igi79/myNixies/img/20190120_131034.jpg

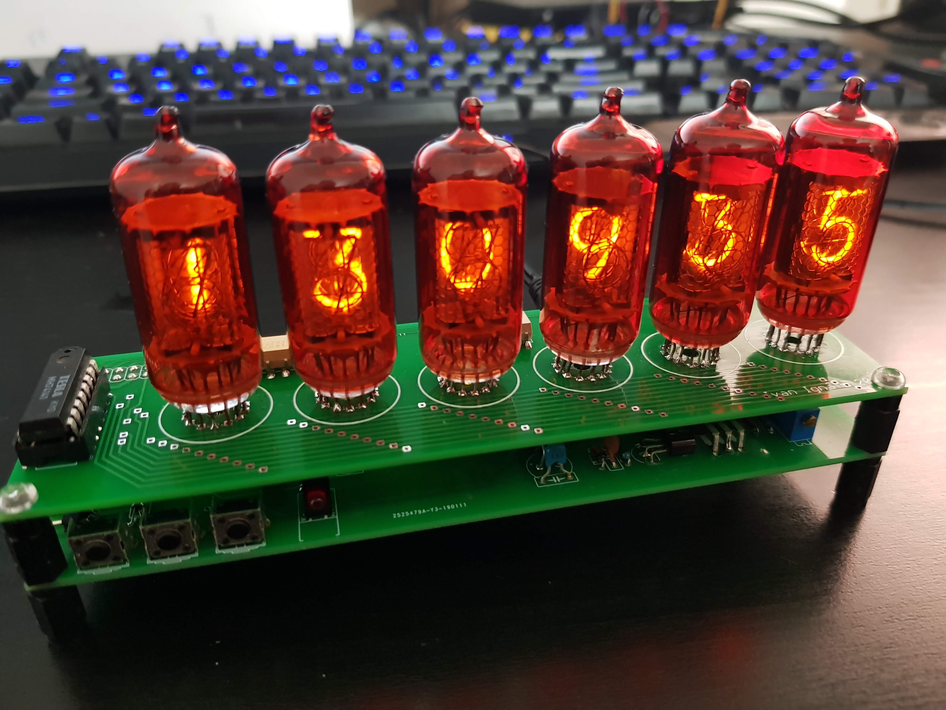
img/20190120_131034.jpg
