igi79/myNixies/img/20190220_234951.jpg

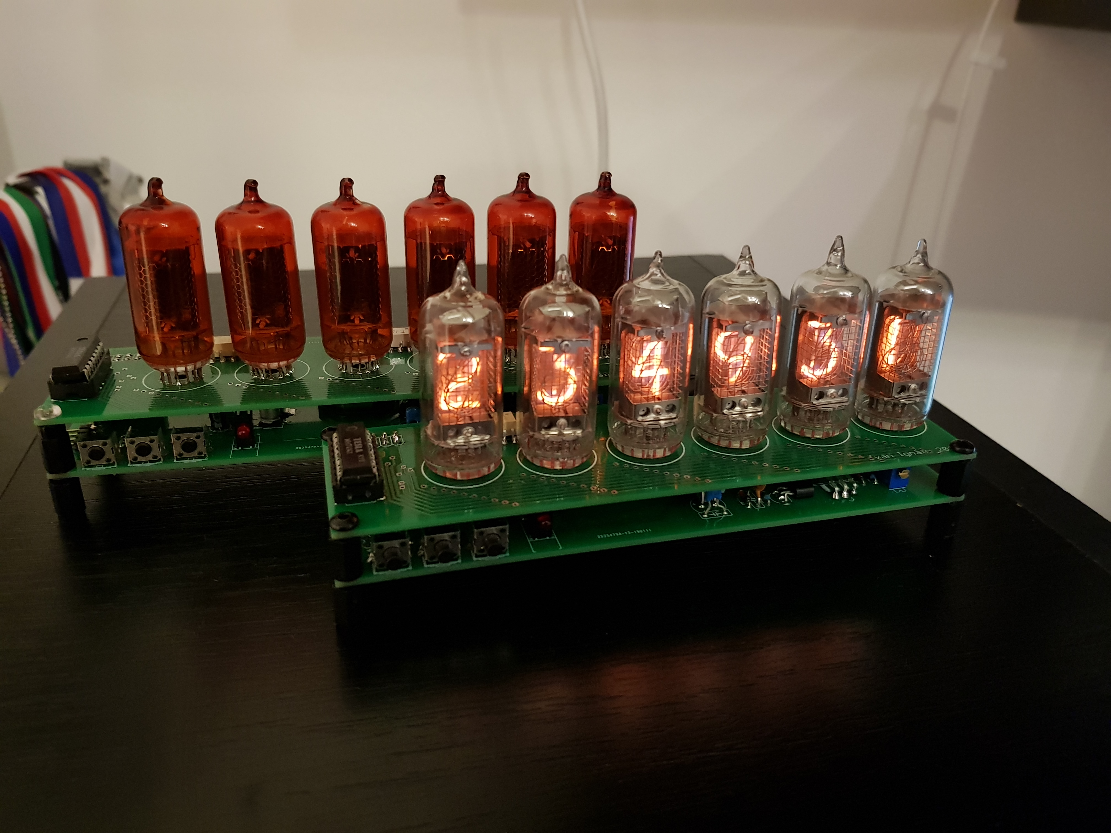
img/20190220_234951.jpg
