igi79/myNixies/PCB/nix3PowerFinal.brd

## EAGLE design PCB/nix3PowerFinal.brd (2019-02-20)

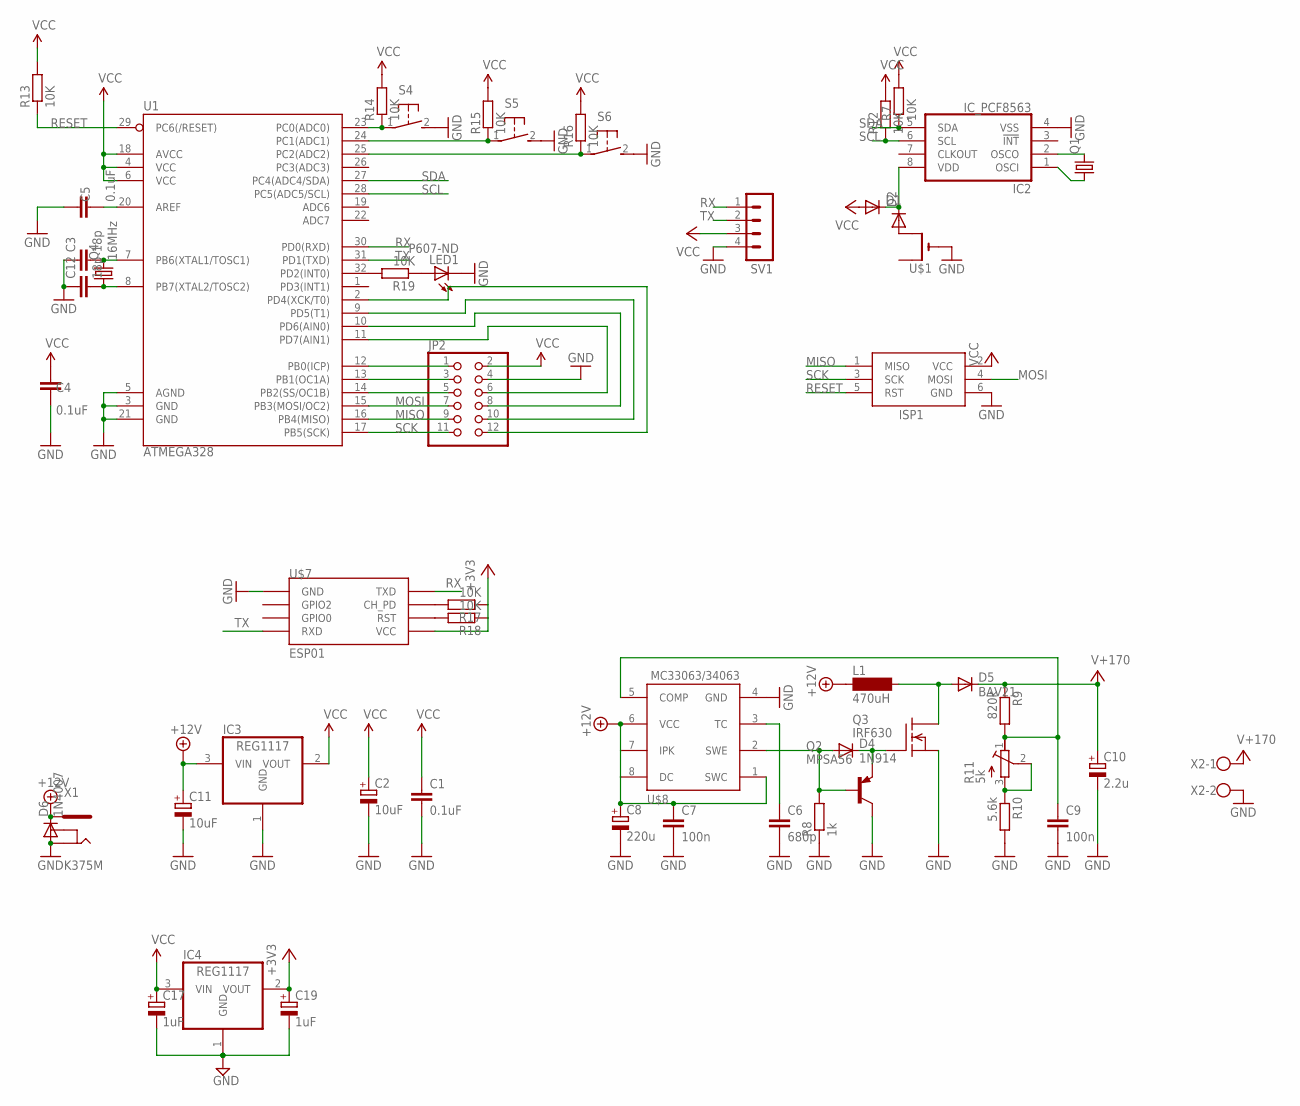
[picture p3: schematic nix3PowerFinal.sch, sheet 1]

Parts:
C1, C4, C5: 0.1uF; C0805
C2, C11: 10uF; E2,5-5
C3, C12: 18p; C0805
C6: 680p; C050-025X075
C7, C9: 100n; C050-025X075
C8: 220u; E3,5-8
C10: 2.2u; E3,5-8
C17, C19: 1uF; 153CLV-0505
D1, D2: DIODE-SOD80C; SOD80C
D4: 1N914; D-5
D5: BAV21; D-5
D6: 1N4007; D-7.5
IC2: IC_PCF8563; SO-8
IC3, IC4: REG1117; SOT223
ISP1: AVRISP-6; AVRISP
JP2: PINHD-2X6; 2X06
L1: 470uH; BS11
LED1: P607-ND; Q62902-B155
Q1: CRYSTALTC38H; TC38H
Q2: MPSA56; TO92-CBE
Q3: IRF630; TO220
Q4: 16MHz; HC49U-V
R7, R12, R13, R14, R15, R16, R17, R18, R19: 10K; R0805
R8: 1k; 0204/5
R9: 820k; 0204/5
R10: 5.6k; 0204/5
R11: 5k; RTRIM43P
S4, S5, S6: 31-XX; B3F-31XX
SV1: MA04-1
U1: ATMEGA328; TQFP32-08
U$1: CR2032THM; CR2032-THRU
U$7: ESP01
U$8: MC33063/MC34063P; DIL08
X1: K375M
X2: W237-102

Connections:
+3V3: C19.+, IC4.2 (VOUT), R17.1, R18.1, U$7.VCC
+12V: C7.1, C8.+, C11.+, D6.C, IC3.3 (VIN), L1.1, U$8.1 (SWC), U$8.6 (VCC), U$8.7 (IPK), U$8.8 (DC), X1.1
GND: C1.2, C2.-, C3.1, C4.1, C5.2, C6.2, C7.2, C8.-, C9.2, C10.-, C11.-, C12.1, C17.-, C19.-, D6.A, IC2.4 (VSS), IC3.1 (GND), IC4.1 (GND), ISP1.6 (GND), JP2.4, LED1.K (C), Q2.C, Q3.3 (S), R8.1, R10.2, S4.2 (S), S5.2 (S), S6.2 (S), SV1.4, U1.3 (GND), U1.5 (AGND), U1.21 (GND), U$1.-, U$7.GND, U$8.4 (GND), X1.2, X2.2
MISO: ISP1.1 (MISO), JP2.9, U1.16 (PB4(MISO))
MOSI: ISP1.4 (MOSI), JP2.7, U1.15 (PB3(MOSI/OC2))
unnamed: IC2.2 (OSCO), Q1.2
unnamed: D2.A, U$1.+2 (+1)
unnamed: C6.1, U$8.3 (TC)
unnamed: JP2.5, U1.14 (PB2(SS/OC1B))
unnamed: JP2.3, U1.13 (PB1(OC1A))
unnamed: JP2.1, U1.12 (PB0(ICP))
unnamed: IC2.1 (OSCI), Q1.1
unnamed: D1.C, D2.C, IC2.8 (VDD)
unnamed: C3.2, Q4.2, U1.7 (PB6(XTAL1/TOSC1))
unnamed: C12.2, Q4.1, U1.8 (PB7(XTAL2/TOSC2))
unnamed: R19.2, U1.32 (PD2(INT0))
unnamed: LED1.A, R19.1
unnamed: R17.2, U$7.CH_PD
unnamed: R18.2, U$7.RST
unnamed: JP2.12, U1.2 (PD4(XCK/T0))
unnamed: JP2.6, U1.11 (PD7(AIN1))
unnamed: D4.C, Q2.E, Q3.1 (G)
unnamed: D5.A, L1.2, Q3.2 (D)
unnamed: D4.A, Q2.B, R8.2, U$8.2 (SWE)
unnamed: C9.1, R9.2, R11.1 (A), U$8.5 (COMP)
unnamed: R10.1, R11.2 (S), R11.3 (E)
unnamed: C5.1, U1.20 (AREF)
unnamed: JP2.8, U1.10 (PD6(AIN0))
unnamed: JP2.10, U1.9 (PD5(T1))
unnamed: R14.1, S4.1, U1.23 (PC0(ADC0))
unnamed: R15.1, S5.1, U1.24 (PC1(ADC1))
unnamed: R16.1, S6.1, U1.25 (PC2(ADC2))
RESET: ISP1.5 (RST), R13.1, U1.29 (PC6(/RESET))
RX: SV1.1, U1.30 (PD0(RXD)), U$7.TX (TXD)
SCK: ISP1.3 (SCK), JP2.11, U1.17 (PB5(SCK))
SCL: IC2.6 (SCL), R12.1, U1.28 (PC5(ADC5/SCL))
SDA: IC2.5 (SDA), R7.1, U1.27 (PC4(ADC4/SDA))
TX: SV1.2, U1.31 (PD1(TXD)), U$7.RX (RXD)
V+: C10.+, D5.C, R9.1, X2.1
VCC: C1.1, C2.+, C4.2, C17.+, D1.A, IC3.2 (VOUT), IC4.3 (VIN), ISP1.2 (VCC), JP2.2, R7.2, R12.2, R13.2, R14.2, R15.2, R16.2, SV1.3, U1.4 (VCC), U1.6 (VCC), U1.18 (AVCC)

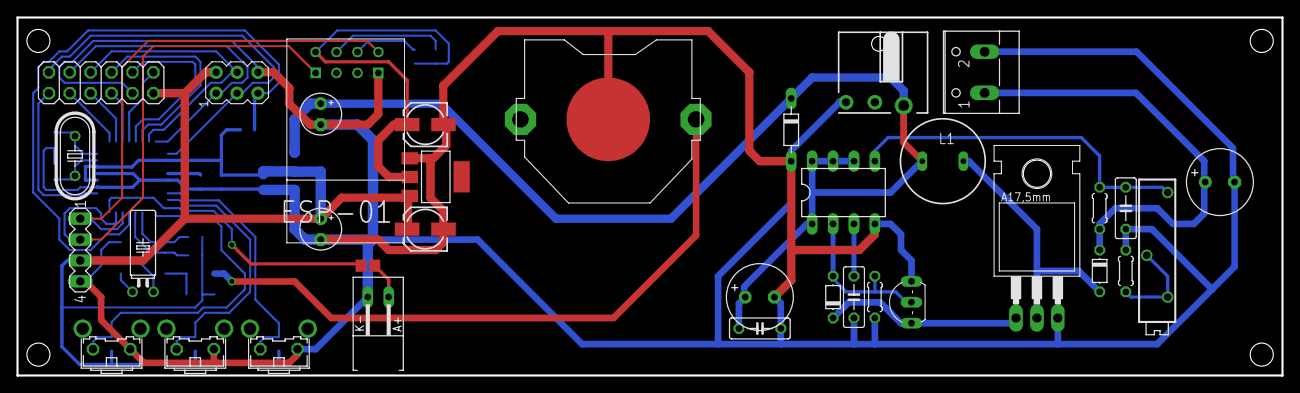
[picture p4: board nix3PowerFinal.brd from above]

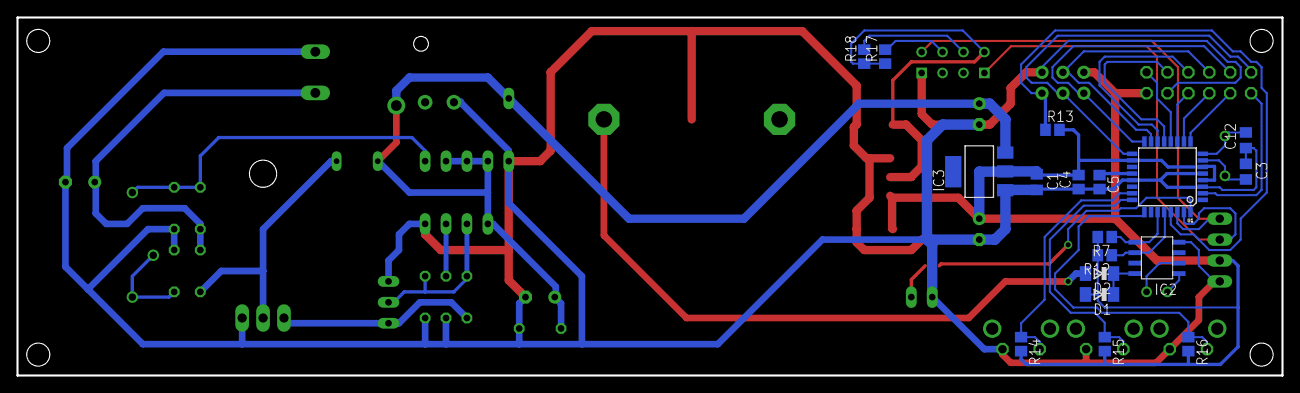
[picture p5: board nix3PowerFinal.brd from below]

Board: 2 copper layers, 153.7 x 43.5 mm, 53 parts (18 on the bottom side), 40 nets.
