igi79/myNixies/PCB/nix3SocketsFinal.brd

## EAGLE design PCB/nix3SocketsFinal.brd (2019-02-20)

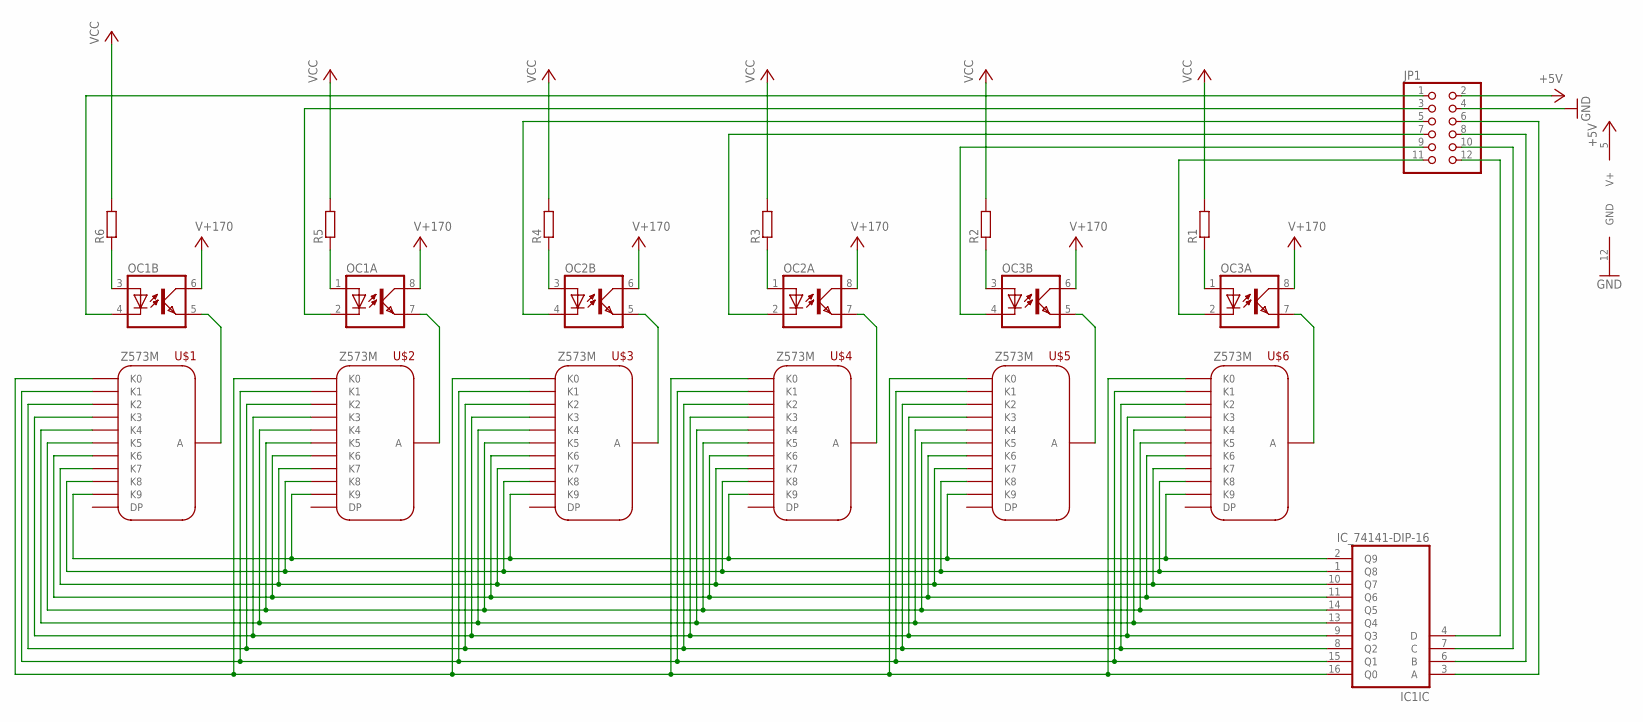
[picture p6: schematic nix3SocketsFinal.sch]

Parts:
IC1: IC_74141-DIP-16; DIL16
JP1: PINHD-2X6; 2X06
OC1, OC2, OC3: ILD621; DIL08
R1, R2, R3, R4, R5, R6: R-EU_R0805W; R0805W
U$1, U$2, U$3, U$4, U$5, U$6: Z573M

Connections:
+5V: IC1.5 (V+), JP1.2, R1.2, R2.2, R3.2, R4.2, R5.2, R6.2
GND: IC1.12 (GND), JP1.4
unnamed: IC1.2 (Q9), U$1.K9, U$2.K9, U$3.K9, U$4.K9, U$5.K9, U$6.K9
unnamed: IC1.1 (Q8), U$1.K8, U$2.K8, U$3.K8, U$4.K8, U$5.K8, U$6.K8
unnamed: IC1.10 (Q7), U$1.K7, U$2.K7, U$3.K7, U$4.K7, U$5.K7, U$6.K7
unnamed: IC1.11 (Q6), U$1.K6, U$2.K6, U$3.K6, U$4.K6, U$5.K6, U$6.K6
unnamed: IC1.14 (Q5), U$1.K5, U$2.K5, U$3.K5, U$4.K5, U$5.K5, U$6.K5
unnamed: IC1.13 (Q4), U$1.K4, U$2.K4, U$3.K4, U$4.K4, U$5.K4, U$6.K4
unnamed: IC1.9 (Q3), U$1.K3, U$2.K3, U$3.K3, U$4.K3, U$5.K3, U$6.K3
unnamed: IC1.8 (Q2), U$1.K2, U$2.K2, U$3.K2, U$4.K2, U$5.K2, U$6.K2
unnamed: IC1.15 (Q1), U$1.K1, U$2.K1, U$3.K1, U$4.K1, U$5.K1, U$6.K1
unnamed: OC3.7 (EMIT), U$6.A
unnamed: IC1.16 (Q0), U$1.K0, U$2.K0, U$3.K0, U$4.K0, U$5.K0, U$6.K0
unnamed: OC1.5 (EMIT), U$1.A
unnamed: OC1.7 (EMIT), U$2.A
unnamed: OC2.5 (EMIT), U$3.A
unnamed: OC2.7 (EMIT), U$4.A
unnamed: OC3.5 (EMIT), U$5.A
unnamed: JP1.11, OC3.2 (C)
unnamed: JP1.9, OC3.4 (C)
unnamed: JP1.7, OC2.2 (C)
unnamed: JP1.5, OC2.4 (C)
unnamed: JP1.3, OC1.2 (C)
unnamed: JP1.1, OC1.4 (C)
unnamed: IC1.4 (D), JP1.12
unnamed: IC1.7 (C), JP1.10
unnamed: IC1.6 (B), JP1.8
unnamed: IC1.3 (A), JP1.6
unnamed: OC1.3 (A), R6.1
unnamed: OC1.1 (A), R5.1
unnamed: OC2.3 (A), R4.1
unnamed: OC2.1 (A), R3.1
unnamed: OC3.3 (A), R2.1
unnamed: OC3.1 (A), R1.1
V+: OC1.6 (COL), OC1.8 (COL), OC2.6 (COL), OC2.8 (COL), OC3.6 (COL), OC3.8 (COL)

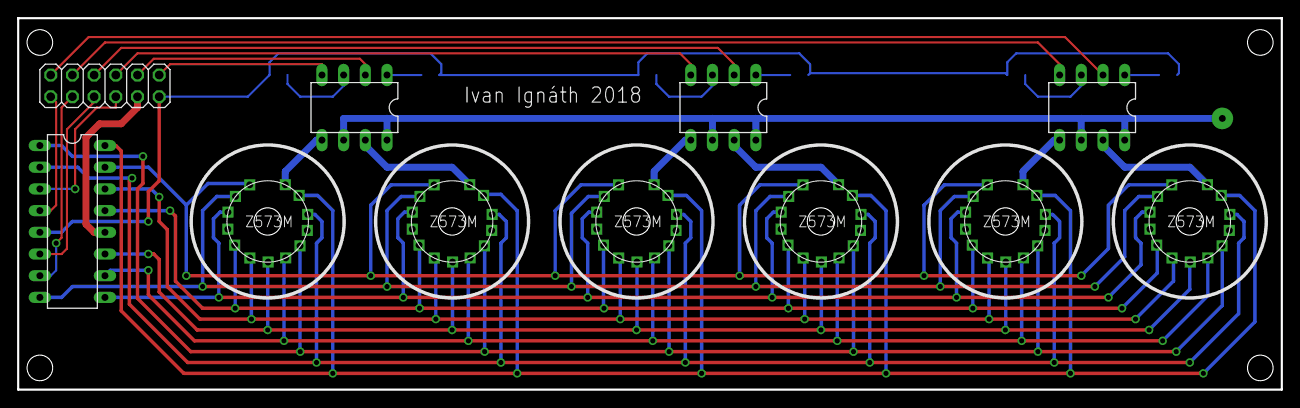
[picture p7: board nix3SocketsFinal.brd from above]

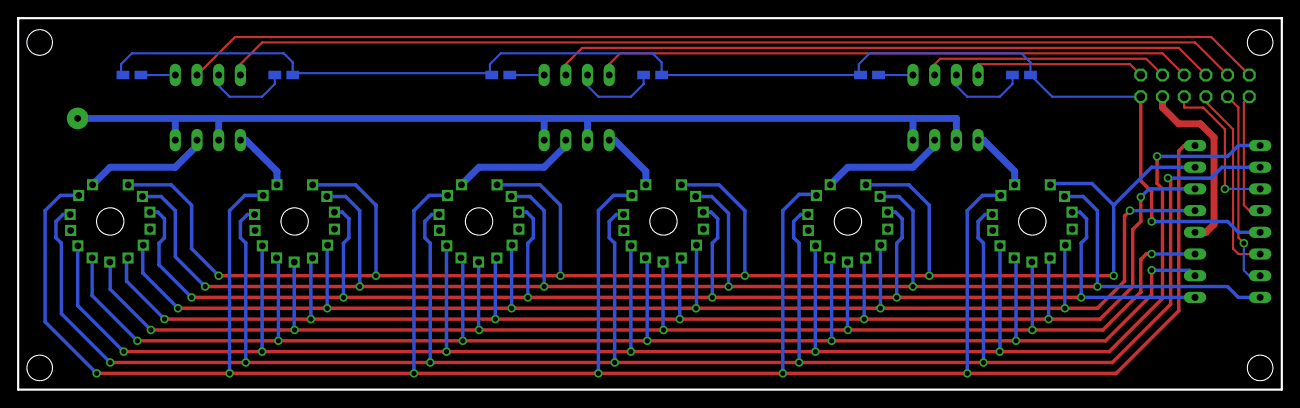
[picture p8: board nix3SocketsFinal.brd from below]

Board: 2 copper layers, 147.9 x 43.5 mm, 17 parts (6 on the bottom side), 35 nets.
